HasanJamal96/digital-lock/Documents/DL1500 Specification A.docx

## DL1500 Digital Lock Specification

Revision A, 03/23/2023

## Overview:

The DL1500 Digital Lock is a device that will be used for access control of a gate or door. The system will consist of a PCB with keypad, and a smart phone app for programming. When a valid user (guest) enters a code on the built-in keypad, the device will activate as programmed. Each user (guest) will have User Schedules with programmable settings such as dates, times, to determine if their entry code is valid at that time. Other features will include but not limited to: Relay schedules, Exit input, etc. Because the device will commonly be installed where internet access is not available, all memory and commands will be stored locally on the device. This includes all entry codes, entry code schedules, relay schedules, and other device settings. A simple Plug & Play setup is required for user friendly setup. Programming of the features by the mobile app will be local through a direct wifi connection to the device.

Note: This is a simple standalone digital lock system with all memory and commands generated by the device. A simple mobile app will be used for simple programming of User (Guest) codes, schedules, and all system settings.

Note: Consider using WiFi programming for future remote programming via mobile app to web server to device.

## Mechanical Specifications Overview:

1. Power input 12-24 AC or DC, Reverse Polarity protected = can switch polarity without failure. Power input to PCB. Power will be supplied by an outside power source – usually the gate motor or a plug-in transformer.
2. Power draw Power draw should be minimal so unit can be used in solar applications.
3. Exit input Exit Input shall have Exit and C. Input will allow an external device such as a pushbutton to be connected to the system to operate the relay. When the Exit circuit is connected, the relay will activate and remain active until the circuit is disconnected. When the Exit circuit is disconnected, the relay will deactivate unless a Hold command or Open Schedule is active. Exit input is a connection between EXIT and Common.
- ON = Circuit activates the relay when circuit is High (connection between EXIT and C).
- OFF = Circuit deactivates relay when circuit is Low (no connection between EXIT and C) unless a different command is activating the relay.
4. Number of relays One (1) relay shall be available. Relay shall have NO, NC, C outputs.
5. Relay functions None, momentary hh:mm:ss, latch, unlatch, toggle
- None = Relay is not activated
- Momentary hh:mm:ss = Relay is activated for set time. Time needs to be programmable with hour:minute:second format.
- Latch = Relay is activated and will not deactivate until an Unlatch command is given. Unlatch command can be unlatch code or unlatch schedule.
- Unlatch = Relay is deactivated.
- Toggle = Relay is activated when valid toggle code is entered, then deactivated when valid toggle code is entered again.
6. 7-Day Timer The device shall have an onboard time clock for time control of relays and entry codes. Timed functions will include start date, end date, start time, end time, days of week.
7. Time clock battery backup Built-in battery backup to maintain the time clock settings for 24 hours or longer
8. Buzzer A built-in buzzer shall be on the PCB and activate when buttons are pressed and certain criteria is met. Examples but not limited to:
- Buzzer will sound for every keypad button pressed so user knows button was pressed.
- Buzzer will sound if valid code is entered
- Buzzer will sound if invalid code is entered
- Buzzer will sound for correct program steps when keypad programming
- Buzzer will sound for incorrect program steps when keypad programming
9. Reset button A built-in button shall be on the PCB to allow the device to be physically reset. Reset functions will include:
- Reset all settings and clear memory of device
- Reset program password only without clearing any memory on the device
10. Status LEDs Built-in LEDs shall be on the PCB to show the status of power and relay:
- Power LED is ON when power is supplied to the device
- Relay LED is ON when relay is active
- Exit LED is ON when exit input is active (connection between Exit and Common)
11. Wireless Module Built-in module will allow authorized users to access the device for local programming. Module can be WiFi. Note: WiFi programming for future remote programming via mobile app to web server to device.
12. System Processor A built in processor (such as an Atmel processor or Micro Chip) will be used for the system to function as a standalone device not connected to a remote server or the internet. Processor needs to be fast enough and powerful enough for all functions to be local. Processor will also function as a local server for programming. (Previous product used Micro Chip PIC18F26K20-I/SO)
13. System Memory Built-in memory will be used for the system to function as a standalone device not connected to a server or the internet. Memory needs to be large enough for all functions, settings, and a minimum of 1000 user entry codes. (Future versions may include WiFi Server connection, fingerprint recognition, and/or RFID.)
14. Keypad Connector Shall have a plug-in connector from for external waterproof metal keypad. Connector shall be mounted vertical on board to help prevent moisture buildup on connections. Connector shall prevent keypad cable from being plugged in backwards.
15. Wiring Terminal Built-in wiring terminal for all input and outputs:
- Power 12-24 AC/DC reverse polarity protected
- Power 12-24 AC/DC reverse polarity protected
- Exit Input
- Exit Common
- Relay NO
- Relay C
- Relay NC
16. FCC Components Wi-Fi components shall be FCC approved. Unit shall be compliant with FCC Part 15 and Part 68.
17. Temperature -20C to 60C
18. Humidity 5% to 100%
19. Surge protection Shall have built-in surge protection on all inputs.

## Feature Specification Overview:

1. Direct Connect Programming A simple direct connection shall be used for local programming of all features and settings. Page needs to be simple and user friendly. Will be for Android and iPhone.
2. Direct Connect Page A simple direct connection page shall be developed for programming and end user control of the device. Basic features will include but not limited to: Open button, Hold button, Close button, view system status, and program system settings. Will be for Android and iPhone.
3. Keypad Programming Programming can be done using the metal keypad when mobile app programming is not used. Audible feedback from the built-in buzzer will assist in programming verification. Keypad programming will be limited to basic program functions such as adding/editing a guest code and setting the date & clock.
4. System Status System status can be viewed when the app connects to the device. Should display the Device Name, Device date, Device time, current state of Relay, Exit input, and any active relay schedule.
5. Entry Codes User (Guest) Entry Codes will be the 4-6 digit number assigned to a user (guest). The device will look at the entry code settings to determine if a user’s code is valid or invalid. A minimum of 1000 entry codes shall be available. Entry codes (and MAC ID if implemented) settings will include:
- Entry code
- User (guest) name. Default = Blank
- Time Schedule: Default = None (no schedule)
- Relay Function. Default = Momentary 00:00:02
- Limited Use = Off (unlimited use)
6. User (Guest) Name A name can be assigned to each User (Guest). If a code is programmed via the keypad instead of a smart phone, the name will be the default Blank. Default = Blank (no name)
7. User (Guest) Relay Functions Relay Default = Momentary 00:00:02 (hh:mm:ss).
- None: Entry code does not activate relay.
- Momentary: Entry code activates relay for hh:mm:ss and then deactivates.
- Latch: Entry code can only latch the relay.
- Unlatch: Entry code can only unlatch the relay.
- Toggle: Entry code will Latch the relay on first activation, and unlatch the relay on next activation.
8. User (Guest) Time Schedule Each user (guest) can have its own time schedule to determine when the code is valid or invalid. If a code is used during the active schedule = valid. If a code is used during an inactive schedule = invalid. Settings should include Start Date, End Date, Start Time, End Time, Days of the Week. Default = No time schedule, always valid.
9. User (Guest) Limited Use A setting allowing a user (guest) entry code to be used xxx amount of times. Once the number of times has been used, the code becomes inactive. Example: a contractor may be given a code that will open the gate 10 times. On the 11th try, the code will not open the gate. (Also known as a Flash Code) Default = Off (unlimited uses)
10. Display Entry Code List A list of entry codes including user name should be displayed when programming using the mobile app. List should be able to be displayed numerically by code or alphabetically by user name.
11. Add Entry Code Individual entry codes should be able to be programmed using the app or keypad. When adding a new code using the app, the following settings will be programmed: Code, User (Guest) Name, Relay function, Relay Time schedule, Limited Use setting. When adding a new entry code using the keypad, the following settings will be programmed: Code, Relay function.
12. Edit Entry Code Individual entry codes should be able to be edited using the app or keypad.
13. Delete Entry Codes Individual entry codes should be able to be deleted using the app or keypad.
14. Relay Schedules At least 10 relay schedules can be set to activate or deactivate the relay. Programming will be done by the app and the schedule will include:
- Schedule number: Specific number (01-10) to identify the schedule. The Schedule number will be displayed in Transactions.
- Schedule name: Specific name to identify the schedule. This name will be displayed on the Home Page and in Transactions.
- Schedule: Start date, end date, start time, end time, days of the week
- Relay function: Momentary (hh:mm:ss), latch, unlatch, toggle
15. Display Relay Schedules A list of Relay Schedules should be displayed when the mobile app programming is used.
16. Add Relay Schedules Individual Relay Schedules should be programmed using the app. When adding a new schedule, the following settings will be programmed: Schedule Number (01-10), Schedule Name, Relay Time schedule, Relay function.
17. Edit Relay Schedules Individual Relay Schedules should be able to be edited using the app.
18. Delete Relay Schedules Individual Relay Schedules should be able to be deleted using the app.
20. Device Name A specific name can be given to the unit to help identify it to the user. Example: unit name = front gate. This name will be displayed on the Home Page screen when the app is used. Default = DL1500
21. Device WiFi Name A specific name can be given to the unit to help identify it when listed in a Bluetooth or WiFi List of devices. Sometimes there may be multiple devices close to each other so a specific name for each unit will be required. This name will be displayed on the user’s mobile phone settings. Default = DL1500
19. Device WiFi Password A specific password can be given to the device to access the device network when programming with the mobile app. Default = password
20. Time Clock Programming The built-in 7-Day time clock shall be programmable since the device will not be connected to the internet. Settings will include date and time in 12 hour format.
- Date: MM/DD/YY
- Time: HH:MM:SS (12 hour format)
- AM/PM: Setting
21. Entry Code Length Entry Codes will be 4-6 digits and will be programmable in system settings. All codes will be the same length as set in system settings. Example: If 4-digits is set, then all codes will be 4-digits. If 6-digits is set, then all codes will be 6-digits. Default = 4-digits
22. Lockout Setting Lockout helps prevent unauthorized users from using multiple codes to try to access the system. The system has a 5-minute lockout feature that is activated when “xx” number of invalid entry codes are entered. The count is cleared each time a valid entry code is entered. Once the system enters the lockout mode, it may only be reset by waiting the 5-minutes or resetting power. The default setting is “OFF” which will turn the feature off allowing for unlimited entries.
23. Sleep Mode Sleep mode is used to turn the keypad back light off 30 seconds after use to save power. Once in sleep mode, any key pressed will turn the keypad light back on.
22. Programming Access Code A simple 6-digit numeric password will be used to enter programming mode when using the keypad. The password can be changed in system settings. Default password = 000000.
23. Program Code Reset The password should be able to be factory reset back to 000000 if it is ever lost or forgotten. Resetting the password to the factory 000000 should be able to be done without entering programming – backdoor reset. To reset the Program Code back to default 000000:
- Press and hold C (*) and the reset button at the same time for 10 seconds.
- Device will beep two short beeps (BEEP BEEP)
- Press Enter (#) to confirm Program Code reset
- Device will beep three short beeps (BEEP BEEP BEEP)
24. System Reset All settings and memory should be able to be cleared and reset to factory settings. Resetting the system will delete all entry codes and reset all settings to original default settings. To reset the system:
- Press and hold C (*) and Enter (#) and the reset button at the same time for 10 seconds.
- Device will beep two short beeps (BEEP BEEP)
- Press Enter (#) to confirm system reset
- Device will beep three short beeps (BEEP BEEP BEEP)
25. # and * Ignored The # and * keys should be ignored if pressed for less than 4 seconds before or after an entry code is entered. Some competitor products require the * or # to be pressed to start or end the entry code.
24. Transactions The last 20 transactions should be displayed on a Transaction Page. Transactions will include:
- Date: MM/DD/YY
- Time: HH:MM:SS (12 hour format) AM/PM
- Entry Code or Schedule Number
- User Name or Schedule Name
- Action taken:
  - Access Granted
  - Access Denied

## Mobile App Specification Overview:

1. Log In To be determined by development team. Log in to access device for app programming.
- Local WiFi direct connection
- Prefer a name address instead of a numeric address. Example: DL100 instead of 192.168.4.4

HOME PAGE:

1. Home Page Includes Device Name, Open button, Hold button, Close button, Device Time and Date, Relay status, Exit Input status, Schedule status, and buttons to go to pages including: Codes, Schedules, Settings, Transactions.
26. Device Name Will display the current device name.
27. Hold button Should latch and hold the relay until the close button is pressed, unlatched code is entered on the keypad, a toggle off code is entered on the keypad, or a relay schedule unlatches the relay.
28. Open button Should activate the relay for xx:xx:xx time (hh:mm:ss). Default will be 00:00:02 (2 seconds). Needs to be adjustable since different applications require different activation times.
- Setting should be under Entry Code and will be set for each individual user.
29. Close button Should unlatch the relay. Will override Hold open schedule.
30. Device Date & Time Should show the current date & time programmed into the device. Date & time will be set in Device Settings. Time should be displayed in 12 hour format showing AM/PM.
31. Relay status Should show the current state of the Relay (not the last button pressed). Settings displayed will be ON, OFF. When app is opened, it will check the current state of the relay. The status should automatically update when the state of the relay changes.
- ON = Relay NO and C circuit is active
- OFF = Relay NO and C circuit is inactive
32. Exit status Should show the current state of the Exit Input. Settings displayed will be ON, OFF. When app is opened, it will check the current state of the Exit Input.
- ON = Exit Input is active (High) – Connection between Exit & GND
- OFF = Exit Input is inactive (Low) – No connection between Exit & GND

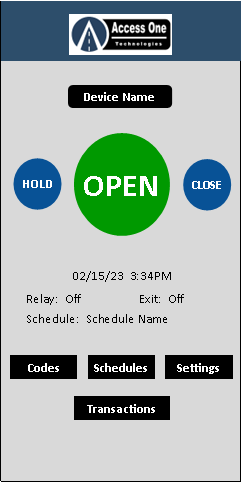
[picture p6: figure]

33. Schedule status Should show the current state of any active relay schedules. When app is opened, it will check the current state of any active relay schedules.
- Schedule Name = Display active relay schedule name
- OFF = If no relay schedule is active
34. Program buttons Program buttons should allow user to select what section of programming to go to:
- Codes = Goes to Entry Code Programming page.
- Schedules = Goes to Relay Schedule Programming page.
- Settings = Goes to Device Settings Programming page.
- Transactions = Goes to Transaction page and displays last 20 transactions.
35. Button v Schedule Whatever command is last will be priority. Examples:
- Relay Open Schedule is active and Hold button is pressed, relay remains latched until Close button is pressed or Open Schedule ends, then relay unlatches.

ENTRY CODE LIST:

A minimum of 1000 Entry Codes should be allowed.

1. Entry Code List A list of entry codes including user name should be displayed when programming using the mobile app to add/edit/delete an entry code. List should be able to be displayed numerically by code or alphabetically by user name. A specific entry code or user name should be able to be selected for programming. Fields include Code, User (Guest) Name.
- Code – Code assigned to Guest

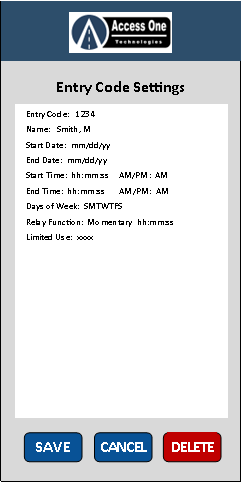
[picture p7: figure]

- Name – Guest Name
36. New/Edit Buttons Buttons used to set up a new entry code or edit an entry code.
- New – When pressed, will go to new Entry Code Settings Page to add new code and user (guest).
- Edit – When an entry code or user name (guest) is selected in the list and then the Edit button is pressed, will go to the existing Entry Code Settings Page for that guest and display current settings. Settings can then be edited.

ENTRY CODE SETTINGS:

1. Entry Code 4-6 Digit code assigned to user (guest). This is the code a user will enter on keypad for access. Default = blank
37. User Name Name assigned to entry code for reference. This is used to help identify the user to a specific code. Default = blank
38. Start Date Start Date entry code becomes valid. Should be mm/dd/yy format. If left blank, then guest immediately becomes valid. Default = blank

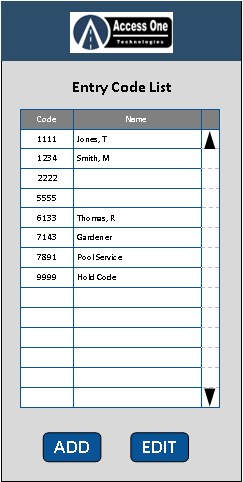
[picture p8: figure]

39. End Date End Date entry code becomes invalid. Should be mm/dd/yy format. If left blank, then no end date = Guest is for all dates. Default = blank
40. Start Time Start time entry code is valid each day. Should be hh:mm:ss AM/PM 12-hour format. If left blank, then no time restrictions – guest is always valid. Default = blank
41. End Time End time entry code is valid each day. Should be hh:mm:ss AM/PM 12-hour format. If left blank, then no time restrictions – guest is always valid. Default = blank
42. Days of Week Days of the week entry code is valid. Sunday – Saturday selections should be available. Code will be valid for each day selected. Default = All days.
25. Relay Function Relay function for each entry code. Each individual code will have its own relay function. Default = Momentary 00:00:02 (2 seconds).
- None: Entry code does not activate relay.
- Momentary: Entry code activates relay for hh:mm:ss and then deactivates. Should be settable for each individual code with hh:mm:ss setting.
- Latch: Entry code can only latch the relay.
- Unlatch: Entry code can only unlatch the relay.
- Toggle: Entry code will Latch relay on first activation, unlatch relay on next activation.
26. Limited Use A setting allowing an entry code to be used xxxx amount of times. Once the number of times has been used, the code inactive. Example: A contractor may be given a code that will open the gate 10 times. On the 11th try, the code will not open the gate. (Also known as a Flash Code) Default = Off (unlimited uses)
43. Save Cancel Delete Save, Cancel, Delete buttons to make changes.

RELAY SCHEDULE LIST: A minimum of 10 Relay schedules should be allowed.

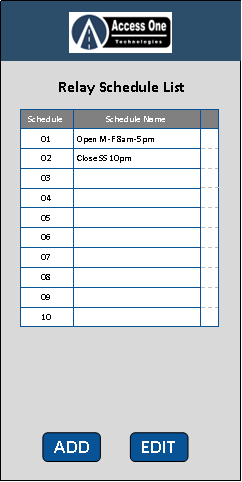
[picture p9: figure]

1. Relay Schedule List Displays a list of all relay schedules and allows the user to select an individual schedule to add or edit the settings. List format should be able to list schedules in order down by Schedule Number. Fields include Schedule Number, Schedule Name. Default = Schedule Name
- Schedule Number – Number assigned to schedule
- Schedule Name – Name assigned to schedule
44. New/Edit Buttons Buttons used to set up a new schedule or edit a schedule.
- New – When pressed, will go to new Relay Schedules Page to add schedule.
- Edit – When a schedule is selected in the list and then the Edit button is pressed, will go to the existing Relay Schedules Page for that schedule.

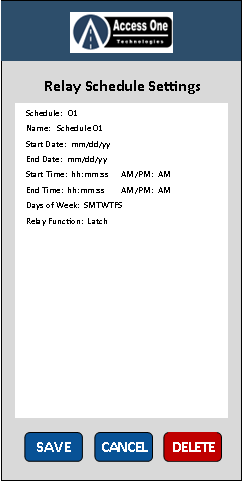
[picture p10: figure]

RELAY SCHEDULE SETTINGS:

1. Schedule Number Number assigned to schedule (01-10). This will be used if feature is ever programmed by the keypad.
2. Schedule Name Name assigned to schedule. Will be displayed in the schedule list and device status on Home Page.
45. Start Date Start Date schedule becomes valid. Should be mm/dd/yy format. If left blank, then schedule immediately becomes valid. Default = blank
46. End Date End Date schedule becomes invalid. Should be mm/dd/yy format. If left blank, then no end date. Default = blank
47. Start Time Start time schedule starts each day. Should be hh:mm:ss AM/PM 12-hour format. If left blank, then schedule will not start. Default = blank
48. End Time End time schedule ends each day. Should be hh:mm:ss AM/PM 12-hour format. If left blank, then schedule will not end = schedule will be on 24 hours. Default = blank
49. Days of Week Days of the week schedule works. Sunday – Saturday selections should be available. Schedules are valid for each day selected. Default = All days.
27. Relay Function Relay function for each schedule. Each individual schedule will have its own relay function. Default = Latch.
- None: Schedule does not activate or deactivate relay.
- Momentary: Schedule activates relay for hh:mm:ss and then deactivates.
- Latch: Schedule activates relay at Start Time, then unlatches relay at End Time.
- Unlatch: Schedule unlatches the relay.
- Toggle: Schedule will Latch the relay on first activation, and unlatch the relay on next activation.
3. Power loss Important: If power is lost during a schedule, relay drops (because no power), the device should check for any active schedules when it powers back on and reactivate the relay.
4. Save Cancel Delete Save, Cancel, Delete buttons to make changes.

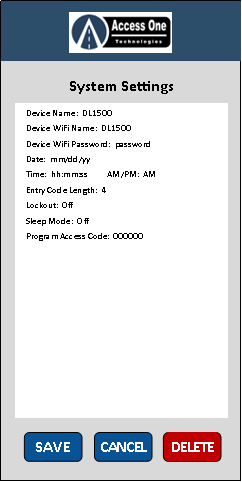
[picture p11: figure]

SYSTEM SETTINGS:

1. Device Name A specific name can be given to the unit to help identify it to the user. Example: unit name = front gate. This name will be displayed on the Home Page screen when the app is used. Default = DL1500
50. Device WiFi Name A specific name can be given to the unit to help identify it when listed in a Bluetooth or WiFi List of devices. Sometimes there may be multiple devices close to each other so a specific name for each unit will be required. This name will be displayed on the user’s mobile phone settings. Default = DL1500
51. Device WiFi Password A specific password can be given to the device to access the device network when programming with the mobile app. Default = password
28. Time Clock Programming The built-in 7-Day time clock shall be programmable by the app or keypad since the device will not be connected to the internet. Settings will include date and time in 12 hour format.
- Date: MM/DD/YY
- Time: HH:MM:SS (12 hour format)
- AM/PM: Setting
29. Device Date Current date to be entered for device. MM/DD/YY format
30. Device Time Current time to be entered for device. HH:MM:SS (12 hour format)
31. Device AM/PM Current AM or PM setting for 12 hour format.
32. Entry Code Length Entry Codes will be 4-6 digits and will be programmable in system settings. All codes will be the same length as set in system settings. Example: If 4-digits is set, then all codes will be 4-digits. If 6-digits is set, then all codes will be 6-digits. Default = 4-digits
33. Lockout Setting Lockout helps prevent unauthorized users from using multiple codes to try to access the system. The system has a 5-minute lockout feature that is activated when “xx” number of invalid entry codes are entered. The count is cleared each time a valid entry code is entered. Once the system enters the lockout mode, it may only be reset by waiting the 5-minutes or resetting power. The default setting is “OFF” which will turn the feature off allowing for unlimited entries.
34. Sleep Mode Sleep mode is used to turn the keypad back light off 30 seconds after use to save power. Once in sleep mode, any key pressed will turn the keypad light back on.
52. Programming Access Code A simple 6-digit numeric password will be used to enter programming mode when using the keypad. The password can be changed in system settings. Default password = 000000.
53. Save Cancel Delete Save, Cancel, Delete buttons to make changes.

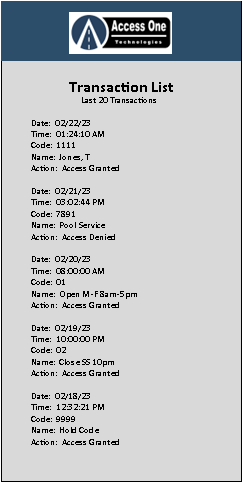
[picture p12: figure]

TRANSACTIONS:

Displays the last 100 transactions including date, time, entry code or schedule number, user name or schedule name, and if access was granted or denied.

1. Transactions The last 100 transactions should be displayed on a Transaction Page. Transactions will include:
- Date: MM/DD/YY
- Time: HH:MM:SS (12 hour format) AM/PM
- Entry Code or Schedule Number
- User Name or Schedule Name
- Action taken:
  - Access Granted
  - Access Denied

## Keypad Programming:

Because the device will not include a LCD display, most programming will be done using a smart phone connected to the device. In some cases where a smart phone is not available, basic programming will be done using the built-in metal keypad. Only simple basic programming will be done because of the complexity of features and options. Features programmable using the keypad will include a simple entry code and the date/time. More complex features will need to be programmed using a smart phone. Future features may need to be added to the keypad programming after customer evaluation.

1. Simple Code A simple entry code shall be programmable using the built-in keypad. A simple code means that most feature defaults will be used to minimize the programming steps. If a more complex code is required, then it will need to be programmed using a smart phone. Features that will be programmable include the entry code number and the relay function momentary or toggle. To program a simple code using the keypad:
- Enter Program Mode:
  - Press and hold the C (*) for 5 seconds
  - Two quick normal beeps sound (Beep Beep)
- Enter the Program Access Code (default = 000000)
  - Enter the 6-Digit Program Access Code then press Enter (#)
  - Two quick normal beeps sound if valid Program Code (Beep Beep)
  - One long (2 second) beep sounds if invalid Program Code (BEEEEEEP)
- Select Add Code, Edit Code, or Delete Code:
  - Press 1 then press Enter (#) to add new code, or
  - Press 2 then press Enter (#) to edit existing code, or
  - Press 3 then press Enter (#) to delete an existing code
  - Two quick normal beeps sound (Beep Beep)
- Enter Code (Default = 4-digits)
  - Enter entry code and then press Enter (#)
  - Two quick normal beeps sound if valid Code (Beep Beep)
  - One long (2 second) lower beep sounds if invalid Code (BEEEEEEP)
- Select relay function:
  - Press 1 then press Enter (#) for Momentary 00:00:02 (2 seconds)
  - Press 2 then press Enter (#) for Toggle
  - Three quick normal beeps confirm code is programmed (Beep Beep Beep)
- Exit Program Mode:
  - Press and hold the C (*) for 5 seconds to exit programming
  - Two long normal beeps sound to confirm exit. (BEEEEEEP, BEEEEEEP)
- All other defaults are set for the code. Simple code settings:
  - User Name = blank
  - Start Date = blank (todays date)
  - End Date = blank (no end date)
  - Days of Week = MTWTFSS (all days)
  - Limited Use = Off
54. Clock The date and time shall be programmable using the built-in keypad. Date format shall be mm/dd/yy. Time format shall be 12-hour hh:mm:ss AM/PM. To program the clock using the keypad:
- Enter Program Mode:
  - Press and hold the C (*) for 5 seconds
  - Two quick normal beeps sound (Beep Beep)
- Enter the Program Access Code (default = 000000)
  - Enter the 6-Digit Program Access Code and then press Enter (#)
  - Two quick normal beeps sound if valid Program Code (Beep Beep)
  - One long (2 second) lower beep sounds if invalid Program Code (BEEEEEEP)
- Select Clock:
  - Press 3 then press Enter (#) to set clock
  - Two quick normal beeps sound (Beep Beep)
- Enter Date (mmddyy) Example: April 19, 2021 = 041921
  - Enter date (mmddyy) and then press Enter (#)
  - Two quick normal beeps sound (Beep Beep)
- Enter Time in 12-hour format (hhmmss) Example: 03:30:00 = 033000
  - Enter time (hhmmss) and then press Enter (#)
  - Two quick normal beeps sound (Beep Beep)
- Enter AM/PM:
  - Press 1 and then press Enter (#) for AM, or
  - Press 2 and then press Enter (#) for PM
  - Three quick normal beeps confirm clock is programmed (Beep Beep)
- Exit Program Mode:
  - Press and hold the C (*) for 5 seconds to exit programming
  - Two long normal beeps sound to confirm exit. (BEEEEEP, BEEEEEEP)

## Buzzer functions and sounds:

1. Keypad press Short normal beep when any button on the keypad is pressed (Beep)
55. Valid Code/ID Two short normal beeps when a valid code is entered on the keypad (Beep Beep)
56. Invalid Code/ID One long beep (2 seconds) when an invalid code is entered on the keypad (BEEEEEEP)
57. Keypad Programming Specified under keypad program section.

## Remote Server Specification Overview:

58. Remote Web Server Should be considered for future version - To be determined by development team.
- Remote server should be available for simple connection from a remote mobile phone to the device.
- Remote server will serve as a bridge between the mobile phone and device when the mobile phone is not in local range to connect directly to the device.
- Device will hold all memory and commands.

## Keypad Specs:


The keypad and specs for this device will be:

Manufacturer: YuYao JieXin Electronics Technologies Co., LTD

Model Number: JXS01B-QR

http://www.jiexinsuper.com/productshow/420.html

## Revision Overview & Options:

Multiple units will be developed for a full line of digital locks. Possibly consider a single PCB to handle all or most units and features are turned on/off by firmware revision. Example: DL100 is a very simple unit with only 100 codes and no time clock features but a different firmware version would allow for time clock features and more memory making it the DL1500. And a different version of firmware would allow for WiFi Server connection for the DL1500-MG. All three units use the same board but features allowed are set by firmware installed.

1. DL100 Very basic and low cost unit. Minimal features available.
2. DL1500 Standard unit with 7-Day Timer. Standard features available.
3. DL1500-MG Standard unit with 7-Day Timer and Web Server connection for remote programming and activation.
4. DL2000 Advanced unit with 7-Day Timer, Fingerprint reader and/or RFID reader.
5. DL2000-MG Advanced unit with 7-Day Timer, Fingerprint reader and/or RFID reader, and Web Server connection for remote programming and activation.

## Revision Changes:

Revision | Date | Changes & Notes
A | 03/23/23 | Original spec

Access One Technologies

316 Maidu Dr

Chester, CA 96020

(530) 931-8118
