HasanJamal96/digital-lock/Circuit/Fritzing.png

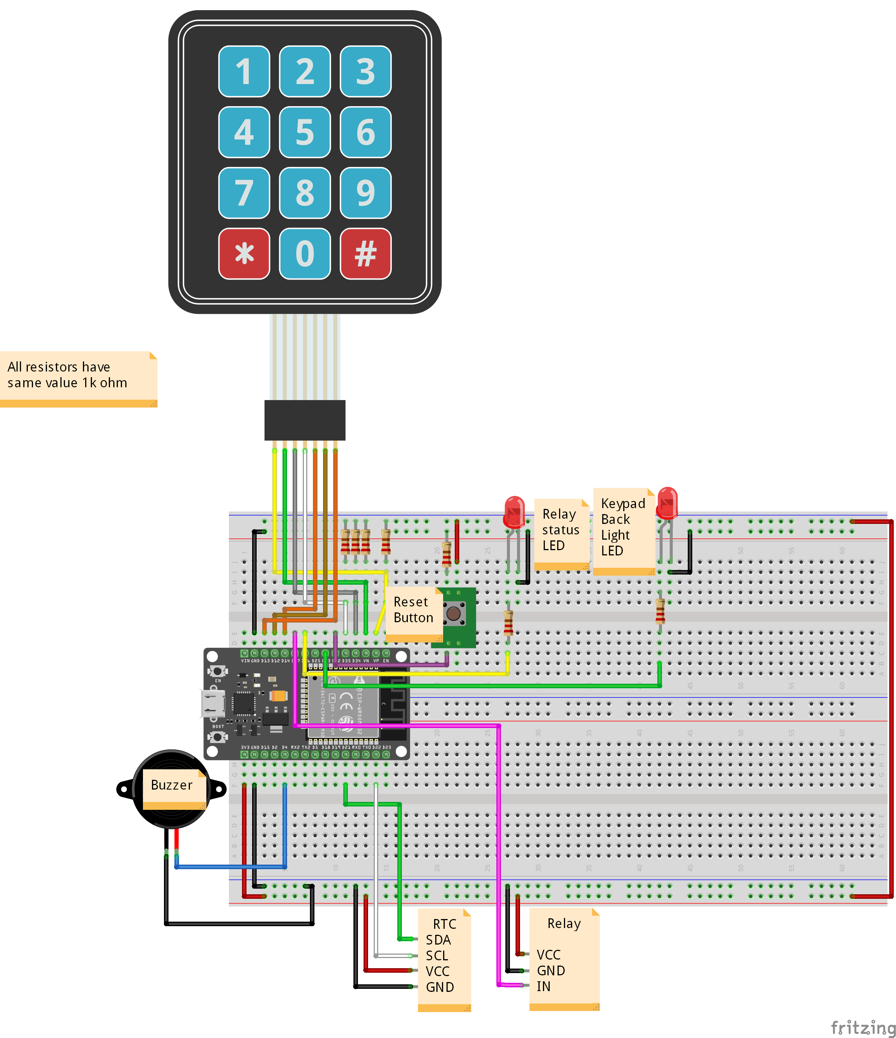
Circuit/Fritzing.png
