HasanJamal96/digital-lock/Documents/Components list.xlsx

Items | URL
Breadboard | https://www.amazon.com/Valuepro-BB-4T7D-3220-Point-Solderless-Breadboard/dp/B00KHE7O7Q
Keypad | https://www.amazon.com/Membrane-Keyboard-Control-Microprocessor-Controller/dp/B0CKRZTVLH
ESP32 | https://www.amazon.com/KeeYees-ESP32-Development-Board-Breakout/dp/B0BGHKMSH2
1k Resistors | https://www.amazon.com/Resistor-Tolerance-Resistors-Limiting-Certificated/dp/B08QRR8P3F
Buzzer | https://www.amazon.com/KY-006-Passive-Buzzer-Module-Arduino/dp/B09P4648NV
LEDs | https://www.amazon.com/Diffused-Lighting-Electronics-Components-Emitting/dp/B01C3ZZT2I
3.3v Single channel Relay | https://www.amazon.com/Channel-Module-Trigger-Optocoupler-Isolation/dp/B0BQDRDJ56
RTC | https://www.amazon.com/modules-Memory-Without-Battery-Quality/dp/B07Z4547N6
Jumper wires | https://www.amazon.com/Piece-Jumper-Dupont-Cable-SciencePurchase/dp/B00NJ3SIVS
Ethernet Module | https://www.amazon.com/Arduino-Ethernet-Network-Modules-Interface/dp/B07VKGTM9W
Battery for RTC | https://www.amazon.com/Energizer-Electronic-Specialty-Battery-2032BP4/dp/B00D8P5T0U
Push Button | https://www.amazon.com/Momentary-Pushbutton-Switches-Breadboard-Electronic/dp/B09R47N37H
RFID Module and Tag | https://www.amazon.com/MFRC-522-Antenna-Wireless-Arduino-Proximity/dp/B0C5QTH29L
IO Extender | https://www.amazon.com/Expansion-Expander-Evaluation-Development-Interface/dp/B0982CLSS8
Fingerprint Sensor | https://www.amazon.com/Optical-Fingerprint-Arduino-Communication-Interface/dp/B093FXD462 | it can save upto 160 fingerprints
