HasanJamal96/digital-lock/(list of files, drawings)

Other design files:
Circuit/Fritzing.fzz
