HasanJamal96/digital-lock/Scripts/main/Keypad.cpp

#include "Keypad.h"


Keypad::Keypad(char *userKeymap, byte *row, byte *col, byte numRows, byte numCols) {
	rowPins = row;
	columnPins = col;
	sizeKpd.rows = numRows;
	sizeKpd.columns = numCols;

	// begin(userKeymap);
  keymap = userKeymap;

	// setDebounceTime(10);
	// setHoldTime(500);
	// keypadEventListener = 0;

	startTime = 0;
	single_key = false;
  for (byte r=0; r<sizeKpd.rows; r++) {
		pin_mode(rowPins[r], INPUT_PULLUP);
	}
  for (byte c=0; c<sizeKpd.columns; c++) {
		pin_mode(columnPins[c],OUTPUT);
  }
}

// void Keypad::begin(char *userKeymap) {
//     keymap = userKeymap;
// }

// char Keypad::getKey() {
// 	single_key = true;

// 	if (getKeys() && key[0].stateChanged && (key[0].kstate==PRESSED))
// 		return key[0].kchar;
	
// 	single_key = false;

// 	return NO_KEY;
// }

// Populate the key list.
bool Keypad::getKeys() {
	bool keyActivity = false;

	if ( (millis()-startTime)>debounceTime ) {
		scanKeys();
		keyActivity = updateList();
		startTime = millis();
	}

	return keyActivity;
}

void Keypad::scanKeys() {
	// for (byte r=0; r<sizeKpd.rows; r++) {
	// 	pin_mode(rowPins[r],INPUT_PULLUP);
	// }

	for (byte c=0; c<sizeKpd.columns; c++) {
		pin_mode(columnPins[c],OUTPUT);
		pin_write(columnPins[c], LOW);	// Begin column pulse output.
		for (byte r=0; r<sizeKpd.rows; r++) {
			bitWrite(bitMap[r], c, !pin_read(rowPins[r]));  // keypress is active low so invert to high.
		}
		pin_write(columnPins[c],HIGH);
		pin_mode(columnPins[c],INPUT);
	}
}

bool Keypad::updateList() {

	bool anyActivity = false;

	for (byte i=0; i<LIST_MAX; i++) {
		if (key[i].kstate==IDLE) {
			key[i].kchar = NO_KEY;
			key[i].kcode = -1;
			key[i].stateChanged = false;
		}
	}

	// Add new keys to empty slots in the key list.
	for (byte r=0; r<sizeKpd.rows; r++) {
		for (byte c=0; c<sizeKpd.columns; c++) {
			boolean button = bitRead(bitMap[r],c);
			char keyChar = keymap[r * sizeKpd.columns + c];
			int keyCode = r * sizeKpd.columns + c;
			int idx = findInList (keyCode);
			if (idx > -1)	{
				nextKeyState(idx, button);
			}
			if ((idx == -1) && button) {
				for (byte i=0; i<LIST_MAX; i++) {
					if (key[i].kchar==NO_KEY) {		// Find an empty slot or don't add key to list.
						key[i].kchar = keyChar;
						key[i].kcode = keyCode;
						key[i].kstate = IDLE;		// Keys NOT on the list have an initial state of IDLE.
						nextKeyState (i, button);
						break;	// Don't fill all the empty slots with the same key.
					}
				}
			}
		}
	}

	for (byte i=0; i<LIST_MAX; i++) {
		if (key[i].stateChanged) anyActivity = true;
	}

	return anyActivity;
}

void Keypad::nextKeyState(byte idx, boolean button) {
	key[idx].stateChanged = false;

	switch (key[idx].kstate) {
		case IDLE:
			if (button==KEY_CLOSED) {
				transitionTo (idx, PRESSED);
				holdTimer = millis(); }		// Get ready for next HOLD state.
			break;
		case PRESSED:
			if ((millis()-holdTimer)>holdTime)	// Waiting for a key HOLD...
				transitionTo (idx, HOLD);
			else if (button==KEY_OPEN)				// or for a key to be RELEASED.
				transitionTo (idx, RELEASED);
			break;
		case HOLD:
			if (button==KEY_OPEN)
				transitionTo (idx, RELEASED);
			break;
		case RELEASED:
			transitionTo (idx, IDLE);
			break;
	}
}

// bool Keypad::isPressed(char keyChar) {
// 	for (byte i=0; i<LIST_MAX; i++) {
// 		if ( key[i].kchar == keyChar ) {
// 			if ( (key[i].kstate == PRESSED) && key[i].stateChanged )
// 				return true;
// 		}
// 	}
// 	return false;	// Not pressed.
// }

// int Keypad::findInList (char keyChar) {
// 	for (byte i=0; i<LIST_MAX; i++) {
// 		if (key[i].kchar == keyChar) {
// 			return i;
// 		}
// 	}
// 	return -1;
// }

int Keypad::findInList (int keyCode) {
	for (byte i=0; i<LIST_MAX; i++) {
		if (key[i].kcode == keyCode) {
			return i;
		}
	}
	return -1;
}

// char Keypad::waitForKey() {
// 	char waitKey = NO_KEY;
// 	while( (waitKey = getKey()) == NO_KEY );	// Block everything while waiting for a keypress.
// 	return waitKey;
// }

// KeyState Keypad::getState() {
// 	return key[0].kstate;
// }

bool Keypad::keyStateChanged() {
	return key[0].stateChanged;
}

// byte Keypad::numKeys() {
// 	return sizeof(key)/sizeof(Key);
// }

// void Keypad::setDebounceTime(uint debounce) {
// 	debounce<1 ? debounceTime=1 : debounceTime=debounce;
// }

// void Keypad::setHoldTime(uint hold) {
//     holdTime = hold;
// }

// void Keypad::addEventListener(void (*listener)(char)){
// 	keypadEventListener = listener;
// }

void Keypad::transitionTo(byte idx, KeyState nextState) {
	key[idx].kstate = nextState;
	key[idx].stateChanged = true;

	// if (single_key)  {
	//   	if ( (keypadEventListener!=NULL) && (idx==0) )  {
	// 		keypadEventListener(key[0].kchar);
	// 	}
	// }
	// else {
	//   	if (keypadEventListener!=NULL)  {
	// 		keypadEventListener(key[idx].kchar);
	// 	}
	// }
}
