HasanJamal96/digital-lock/Scripts/main/Keypad.h

#ifndef KEYPAD_H
#define KEYPAD_H

#include "Key.h"

#if ! (defined(INPUT_PULLUP) || (ARDUINO_API_VERSION >= 10000))
#warning "Using  pinMode() INPUT_PULLUP AVR emulation"
#define INPUT_PULLUP 0x2
#define pinMode(_pin, _mode) _mypinMode(_pin, _mode)
#define _mypinMode(_pin, _mode)  \
do {							 \
	if(_mode == INPUT_PULLUP)	 \
		pinMode(_pin, INPUT);	 \
		digitalWrite(_pin, 1);	 \
	if(_mode != INPUT_PULLUP)	 \
		pinMode(_pin, _mode);	 \
}while(0)
#endif


#define KEY_OPEN LOW
#define KEY_CLOSED HIGH

typedef char KeypadEvent;
typedef unsigned int uint;
typedef unsigned long ulong;

typedef struct {
    byte rows;
    byte columns;
} KeypadSize;

#define LIST_MAX 10		// Max number of keys on the active list.
#define MAPSIZE 10		// MAPSIZE is the number of rows (times 16 columns)
#define makeKeymap(x) ((char*)x)


//class Keypad : public Key, public HAL_obj {
class Keypad : public Key {
public:

	Keypad(char *userKeymap, byte *row, byte *col, byte numRows, byte numCols);

	virtual void pin_mode(byte pinNum, byte mode) { pinMode(pinNum, mode); }
	virtual void pin_write(byte pinNum, boolean level) { digitalWrite(pinNum, level); }
	virtual int  pin_read(byte pinNum) { return digitalRead(pinNum); }

	uint bitMap[MAPSIZE];	// 10 row x 16 column array of bits. Except Due which has 32 columns.
	Key key[LIST_MAX];
	unsigned long holdTimer;

	// char getKey();
	bool getKeys();
	KeyState getState();
	// void begin(char *userKeymap);
	// bool isPressed(char keyChar);
	// void setDebounceTime(uint);
	// void setHoldTime(uint);
	// void addEventListener(void (*listener)(char));
	// int findInList(char keyChar);
	int findInList(int keyCode);
	// char waitForKey();
	bool keyStateChanged();
	byte numKeys();

private:
	unsigned long startTime;
	char *keymap;
  byte *rowPins;
  byte *columnPins;
	KeypadSize sizeKpd;
	uint debounceTime = 10;
	uint holdTime = 500;
	bool single_key;

	void scanKeys();
	bool updateList();
	void nextKeyState(byte n, boolean button);
	void transitionTo(byte n, KeyState nextState);
	// void (*keypadEventListener)(char);
};

#endif
