HasanJamal96/digital-lock/(commit log)

2023-11-13 added valid password relay functions
2023-11-23 removed websocket
    removed websocket from DL100 and DL1500 Timer
2023-11-29 update
    - multiple keypad inputs
    - webapp
    - fritzing
    [Components list.xlsx, DL100-1500-2000 Comparison Chart 03-21-23.xlsx, Fritzing.fzz]
2024-01-13 updated webapp and minor bug fix in hardware code
    [Keypad.cpp, basic_server.h, config.h, main.ino, rtc.h]
2024-01-22 minor updates
    added exit input.
    now user do not have to press # to validate code.
    [DL100-1500-2000 Comparison Chart 03-21-23.xlsx]
